ssosik/phantom-48v-injector-hat/PLAN.md

# Design log / PLAN

Numbered review items, in roughly chronological order. ✅ = closed. Coordinates quoted in
older items predate later component moves; trust the PCB, not the numbers here.

#1 - ✅ HAT stack confirmed: Pi → Phantom Injector HAT → HiFiBerry ADC.
   J1 (B.Cu socket) connects to Pi GPIO. J2 (F.Cu 2×3) connects to HiFiBerry J4.
   HiFiBerry header offset is handled by J2 position on this board. 2-hole mounting
   (MH1/MH2 at top edge) resolves height constraint from HiFiBerry's tall south-edge components.

#2 - ✅ Get proper placement of J2

#3 - ✅ Should there be separate GND planes? Or other separation of components?

#4 - ✅ HiFiBerry and Pi safety verified by simulation.
   Pi rail: π-filter (C1→L2→C6‖C8) gives −51.6 dB attenuation at 404 kHz switching frequency
   — 11.6 dB margin over −40 dB target (PLAN #32). Noise at Pi rail: 0.107 mV/A switching current.
   +48V is galvanically isolated from the Pi 5V rail except through L2/C6/C8 filter.
   DC-block caps (C13–C16, 2.2µF/100V X7R) prevent phantom DC from reaching HiFiBerry inputs.
   Audio path corner: 15 Hz derated (PLAN #33) — well below 20 Hz audio band.

#5 - ✅ what width traces should be used?

#6 - ✅ Are two switches really necessary, or would one suffice? → Decision: one switch (SW1) controls both channels simultaneously. Phantom power is a board-level enable/disable. The EM272 capsules used here all require phantom, so per-channel independent switching adds no value. SW2 removed from design.

#7 - ✅ Locate our J2 connector on the bottom side of the board to match up with J2 of the HiFiBerry

#8 - ✅ GND vias placed. As built (2026-10-29): 52 total — 3×3 grid (0.6/0.3mm) under U1 EP
   + 39 stitching vias (0.8/0.4mm), all GND net.
   Passes thermal_via DRC rule (min 0.6mm). No signal vias needed (single-layer routing).

#9 - ✅ Component separation reviewed and accepted.
   Boost section (U1, L1, L2, D1, Cx) is isolated from phantom injection area by SW1/C3 column.
   XLR connectors (J3/J4) and injection resistors (R6–R9) are in the southern zone x=100–135.
   GND pour provides isolation between zones. No additional separation required.

#10 - ✅ should the LED be on all the time, or only when the 48v switch is set?
   → Only when switched: R10 moved from +48V to +48V_SW so D2 means "phantom applied" (commit 7cfcf93).

## PCB layout optimizations (from placement review)

#11 - ✅ Move C1 (VIN bypass 10µF) and C18 (BIAS bypass 100nF) closer to U1.
   Resolved: C1 and C18 moved to y=65.48, now 5.1–5.3mm from U1. Acceptable.

#12 - ✅ D1→FB1 resolved. FB1 is now at (154.41, 80.22), 6.90mm from D1. ✓
   FB1 moved from x=128 to x=154, now sitting just left of D1/C9 column. Output side:
   FB1→C11 edge-to-edge = 0.82mm. Output cap row (C3–C11) now at y≈81 to the left of FB1.
   +48V_RAW runs D1 → FB1 (6.9mm) → filtered +48V left to cap row → injection resistors.

#13 - ✅ D1→C9 resolved. Pad-to-pad on +48V_RAW = 2.68mm. ✓
   D1 cathode pad at (156.693, 73.076), C9 +48V_RAW pad at (156.693, 75.761) — same x,
   2.68mm apart. Prior 6.25mm figure was center-to-center; pad-to-pad is the correct
   metric. 2.68mm ≈ 2.7nH additional inductance — negligible at switching frequencies.

#14 - ✅ FBX network resolved. R2→U1 = 3.71mm. ✓
   R2=(150.34, 68.07), U1=(153.87, 66.95) — 3.71mm separation. Excellent.
   R1→D1 = 12.64mm; accepted as non-critical (R1 is 1MΩ; noise into FBX attenuated
   ≈97% by divider ratio; +48V_RAW after C9 is filtered DC).

#16 - ✅ L1/D1 x-offset resolved. Δx=1.27mm, SW_NODE pad-to-pad=3.43mm. ✓
   L1 SW_NODE pad at (157.963, 65.892), D1 SW_NODE pad at (156.693, 69.076).
   3.43mm on the hottest trace — excellent. 1.27mm lateral offset is negligible.

#15 - ✅ J4 vs J3 inconsistency: incorrect, close this item.
   J4 is 2.54mm above R8, J3 is 2.54mm below R6 — both are exactly one pin pitch from their
   bias resistors, symmetric by design. No issue.

## Pre-routing checklist (from assembly/edge audit)

#17 - ✅ SW1 pads are within board. Body overhang is by design.
   All SW1 pads at y=81.97mm (7mm inside board). Bbox extends to y=90.51mm because the
   switch housing/actuator extends 8.5mm below the pad row — panel-mount style. Copper OK.

#18 - ✅ J9 not required. Board connects directly J1↔HiFiBerry; no Pi GPIO pass-through needed.

#19 - ✅ C6/C8 pad gap confirmed safe. Actual pad width=1.175mm (not 2.8mm as assumed).
   Pad-to-pad gap = 2.89 − 2×0.725 = 1.44mm. Passes 0.18mm DRC rule by wide margin.

#20 - ✅ C13/C14 and C15/C16 pad gap confirmed safe.
   Pad height (y-dimension) = 1.450mm → ±0.725mm. Gap = 2.54 − 2×0.725 = 1.09mm. Fine.

#21 - ✅ 2×3 thermal via grid placed under U1 EP. ✓
   6 vias in 2 columns × 3 rows at 1.22mm pitch, centered at (146.89, 67.34) within 0.003mm.
   All /GND net, 0.8mm dia / 0.4mm drill — passes thermal_via DRC rule (min 0.6mm).
   3 additional GND stitching vias placed near boost section: (143.69, 65.30), (143.79, 70.89),
   (149.99, 69.88) — all GND net, same spec. Confirm these are intentional before pour.

#22 - ✅ SW1 moved to x=154.6, directly below C3. +48V input is now a 5.08mm
   vertical trace (C3 pad at x=156.60 → SW1 pad2 at x=156.61). LED (D2/R10) moved
   to x≈138.6, forming a vertical column above the injection row.
   Routing plan (route before GND pour):
     • C3 → SW1 pad2: 5mm vertical at x≈156.6 (trivial)
     • SW1 pad1 (+48V_SW) west along y≈82 → R7 (x=132.5) → R8 (x=102.2)
     • Short stub from main bus → R10 pad1 at (138.56, 79.31): 2.7mm north of y=82
     • R6 and R9 are on y=84.66 — branch south from main bus
   D2 pad2 (GND) at y=87.233 — margin 1.61mm to board edge; same as J3, acceptable.

#23 - ✅ R5 moved. Now at (143.51, 57.16), bbox right=147.85mm. Well clear of board edge.

## Fresh-eyes routing pre-flight (2026-06-03)

#34 - ✅ 2-hole mounting configuration accepted (MH1 at 103.5,47.5 and MH2 at 161.5,47.5,
   both top edge). Board cannot extend south to Pi HAT standard 4-hole positions because the
   HiFiBerry board has tall components on its south edge that constrain the stack height.
   2-point mounting via top standoffs is the correct solution for this stack.

#24 - ✅ SUPERSEDED (2026-06-15). SW1 pad 3 is no longer a no-connect.
   Switch was upgraded SPST → SPDT in the schematic; pad 3 is now wired to GND
   so flipping SW1 off actively drains the phantom rail (+48V_SW → GND through
   R6-R9) instead of letting it decay across the DC-block caps. Gives a cleaner
   audible mute. wire_schematic.py NETLIST line for SW1 now has all three pins
   bound: pin 1 = +48V, pin 2 = +48V_SW (common output to R6-R9), pin 3 = GND.
   See commit 7cfcf93.

#25 - J3 GND pin (pad1) is at y=87.198mm; board bottom edge at y=88.839mm → 1.641mm margin.
   Pad edge to board edge ≈ 0.84mm (1.6mm THT pad). Passes standard fab rules (JLCPCB 0.3mm,
   PCBWay 0.5mm). Flag if fab changes — this is the tightest pad on the board.

#26 - ✅ +5V_PI fully routed — no vias needed. J1 is THT (PAD_ATTRIB_PTH); pads 2 and 4
   are directly accessible from F.Cu. Six 1.0mm-wide F.Cu tracks connect:
   J1:4 ↔ J1:2 (2.54mm) → diagonal/vertical → C6 → C8 → L2 (bus at y=59.716).
   Dangling track resolved — it is the track ending at J1 pad4.

#27 - ✅ (superseded) +5V_FILT is also routed: 23mm bus from L2:2 at (117.55,59.72)
   east to junction at x≈142.5, branching north to R5 and south to C1 → U1 VIN.
   ⚠ ISSUE: Short stubs into U1 VIN pins (pad3, pad7) are 0.25mm wide — violates the
   `power` DRC rule (min 0.5mm). Redraw those stubs at ≥0.5mm before running DRC.
   Affected tracks: near (145.0,66.6), (145.5,67-68), (145.3,68.6).

#28 - assess the layout for hand-placed hot plate soldering. Are these components too close?

## Simulation findings (2026-06-03)

#29 - ✅ SYNC_MODE wiring confirmed correct.
   U1 pin 12 routes through R11 (100kΩ) to GND → Burst + SSFM mode enabled.
   SSFM spreads the 404 kHz tone across ±20%, replacing a discrete EMI tone with
   low-level broadband noise. Correct for audio applications. ✓

#30 - ✅ V_FBX confirmed 1.600V (typ). DESIGN_DOC open item 2 closed.
   R1=1MΩ, R2=34.8kΩ → Vout = 1.60 × (1000/34.8 + 1) = 47.6V.
   Within IEC 61938 phantom power spec 48V ±4V (44–52V). ✓

#31 - ✅ Boost converter checks passed (ngspice simulation).
   IL_peak = 0.390A  (limit: 1.4A Isat, XAL5050-223MEC)  — 3.6× margin ✓
   Output ripple = 33.7mV peak-peak  (limit: 100mV) ✓
   DCM confirmed at 16mA full load ✓
   Open-loop Vout = 46.1V at D=69.2%; closed-loop FB regulates to 47.6V ✓

#32 - ✅ Pi 5V rail filter passes at 404 kHz (analytical simulation).
   Attenuation = −51.6 dB  (target: < −40 dB) — 11.6 dB margin ✓
   π-filter topology (C1 → L2 → C6║C8) gives 12 dB extra vs a simple LC.
   Noise at Pi rail: 0.107 mV per amp of switching current.

#33 - ✅ Audio path −3dB corner confirmed (analytical simulation).
   Nominal (2.2µF, no bias derating): 8.8 Hz
   Derated  (1.3µF effective at 48V): 15.0 Hz  ← design operating point
   Both below 20 Hz audio band; BirdNET bandwidth (0.05–12 kHz) is flat. ✓
   Note: TESTS.md listed 10.6 Hz (used R_inj=6.81kΩ as reference impedance — wrong).
   Correct formula uses R_HFB=8kΩ (HiFiBerry PCM1863 input Z). Simulation confirms 15 Hz.

#35 - ✅ SW1 OFF position shorted +48V to GND (fixed 2026-10-29).
   The schematic had drifted from wire_schematic.py: SW1 pin 2 (common, middle pad) was on +48V
   and pin 3 on GND, so the OFF throw shorted the boost output. The golden had been re-baselined
   with the error. Fix: re-ran wire_schematic.py (only SW1 changed in the netlist), swapped SW1
   pad 1/2 nets on the PCB, rerouted +48V from C3 through a via and a short B.Cu link to pad 1,
   and brought +48V_SW over pad 1 into pad 2 on F.Cu. DRC unchanged (1 accepted exception,
   0 unconnected); schematic parity clean. Golden re-saved. C9 value synced to 100V at the same time.

## Deferred design questions (2026-10-29)

#36 - Phantom switching transients into the HiFiBerry inputs. On SW1 ON, C13–C16 are uncharged,
   so the ADC side of each DC-block cap follows the line side. Estimated ≈ +26 V common-mode at the
   PCM1863 inputs (48 V × 8k / (6.81k + 8k)), decaying with τ ≈ 2.2 µF × 14.8 kΩ ≈ 33 ms; SW1 OFF
   gives ≈ −26 V. Rough first-order estimate; ignores cable/mic capacitance and any HiFiBerry-side
   input network. To do: check the HiFiBerry DAC2 ADC Pro input circuit; if unprotected, add a
   per-leg clamp after the DC-block cap (series R + BAV99 to rails, or low-C TVS) and re-run sim4
   for in-band loss.

#37 - Stack order. DESIGN_DOC §1 says Pi → HiFiBerry → HAT; #1 above says Pi → HAT → HiFiBerry.
   J1 is a bottom-side socket with no pass-through, so Pi → HAT → HiFiBerry leaves the HiFiBerry
   without GPIO (I²S/I²C). To do: test-fit on 11 mm standoffs; check J1 pin length and L1's 5.1 mm
   height against the board above.

#38 - J2 ↔ HiFiBerry J4 wiring. J2 is a top-side vertical header (#7 originally asked for bottom
   side). A 2×3 IDC ribbon swaps the odd and even rows. To do: decide the cable, then trace pin 1
   end to end (J2 pin 1 = R−, per DESIGN_DOC §3.4).

## v2 (2026-10-29)

#39 - ✅ v2 silkscreen. Added Logo_Sosik (project lib phantom-injector-hat.pretty, board-only
   footprint G1) and a title block on F.Silk: name, "v2 2026-10", XLR pin legend
   (1 GND / 2 HOT / 3 COLD), licence. Labels: J4 "R", J3 "L", J2 "TO HIFIBERRY J4", SW1 "P48",
   D2 "ON", U1 pin-1 dot. B.Silk: name + v2 + repo URL. PCB and schematic title blocks set
   to rev v2. One GND stitching via moved (114.78→113.6, 74.9) to clear the text. DRC: silk
   checks clean; only the documented +5V_FILT track_width exception remains.
   SW1 deliberately has no ON/OFF end marks: slide direction vs. pin 1 not yet verified.

## Housekeeping (2026-10-30)

#40 - ✅ Repo is self-contained and fab-ready.
   - LT8362 footprint MSE_16A_ADI copied from the Ultra Librarian download into
     phantom-injector-hat.pretty; U1 retargeted (schematic + PCB); fp-lib-table no longer
     references ../ul_LT8362EMSE-PBF. DRC schematic parity clean, check_netlist OK.
   - The +5V_FILT track_width exception is now a DRC exclusion in .kicad_pro (with its reason),
     so DRC reports 0 violations.
   - make_fab.sh: DRC gate, then Gerbers (9 layers), Excellon PTH/NPTH + maps, pick-and-place
     CSV and BOM into fab/ (gitignored), zipped as phantom-injector-hat-<rev>-gerbers.zip.
   - Open pre-fab items (#36–#38, SW1 direction, LTspice transient) collected in TODO.md.
