ssosik/phantom-48v-injector-hat/BOM.csv

Ref(s) | Qty | Value | Description | KiCad Footprint | Manufacturer | Mfr Part Number | DigiKey PN | DigiKey URL | Unit Price (USD) | Ext Price (USD) | Notes
U1 | 1 | LT8362EMSE-PBF | Boost/SEPIC converter IC MSOP-16-EP | ul_LT8362EMSE-PBF:MSE_16A_ADI | Analog Devices | LT8362EMSE#PBF | 505-LT8362EMSE#PBF-ND | https://www.digikey.com/en/products/detail/analog-devices-inc/LT8362EMSE%23PBF/7599731 | 6.36 | 6.36 | E-grade -40°C to 125°C
L1 | 1 | 22 µH | Shielded power inductor ≥1.4A Isat | Inductor_SMD:L_Coilcraft_XAL5030-XXX | Coilcraft | XAL5050-223MEC | N/A — order direct | https://www.coilcraft.com/en-us/products/power/shielded-inductors/xal/xal5050/ | ~3.00 | 3.00 | ⚠ Not stocked on DigiKey. Order from Coilcraft.com. XAL5030-223MEC does not exist (XAL5030 tops out ~15µH); XAL5050-223MEC is correct. Same 5×5mm pad footprint; body height 5.1mm vs 3.1mm — verify clearance above L1 in Pi/HAT/HiFiBerry stack. Isat~2.55A; 3.6× margin over 0.390A peak (PLAN #31).
L2 | 1 | 2.2 µH | Input EMI filter inductor | Inductor_SMD:L_Wuerth_HCI-7040 | Würth Elektronik | 74437324022 | 732-3331-2-ND | https://www.digikey.com/en/products/detail/wurth-electronics-inc/74437324022/2791071 | 2.35 | 2.35 | Isat=8.4A; DCR=61mΩ; HCI-7040 shielded power inductor
D1 | 1 | SS26S | 60V 2A Schottky rectifier SMA | Diode_SMD:D_SMA | Vishay | SS26S-E3/61T | SS26S-E3/61T | https://www.digikey.com/en/products/search?keywords=SS26S-E3/61T | 0.50 | 0.50 | DO-214AC (SMA) — drop-in package match for B260A. Switched from Diodes Inc. B260A-13-F due to stock-out until Oct 2026.
D2 | 1 | Green LED 3mm | Power indicator LED | LED_THT:LED_D3.0mm | (Generic) | (Generic green LED 3mm) | (any) | https://www.digikey.com/en/products/filter/leds-through-hole/105 | 0.10 | 0.10 | Any standard 3mm green LED; Vf≈2.0V; limited to ~3mA by R10
FB1 | 1 | 600Ω@100MHz 1A | EMI filter ferrite bead 0805 | Inductor_SMD:L_0805_2012Metric_Pad1.05x1.20mm_HandSolder | Murata | BLM21SP601SH1D | BLM21SP601SH1D | https://www.digikey.com/en/products/search?keywords=BLM21SP601SH1D | 0.34 | 0.34 | Power-line type ferrite bead; 2.3A rated; 0805 footprint. Order via Mfr PN — legacy 490-18588-1-ND mis-resolves (2026-06-12).
SW1 | 1 | SW_SPDT | SPDT slide switch P48 enable | Button_Switch_THT:SW_Slide_SPDT_Angled_CK_OS102011MA1Q | C&K | OS102011MA1QN1 | CKN9559-ND | https://www.digikey.com/en/products/detail/c-k/OS102011MA1QN1/1981430 | 0.71 | 0.71 | Right-angle THT; body overhangs board edge by design (PLAN #17)
J1 | 1 | 2×20 GPIO socket | 40-pin Raspberry Pi GPIO female header | Connector_PinSocket_2.54mm:PinSocket_2x20_P2.54mm_Vertical | Sullins | PPPC202LFBN-RC | S7123-ND | https://www.digikey.com/en/products/detail/sullins-connector-solutions/PPPC202LFBN-RC/810259 | 2.22 | 2.22 | ⚠ Verify pin length — needs sufficient projection to mate with Pi GPIO when HiFiBerry is sandwiched below. Consider SparkFun PRT-14017 tall stacking header ($3.50) if clearance is tight.
J2 | 1 | 2×3 pin header | HiFiBerry J4 interface connector | Connector_PinHeader_2.54mm:PinHeader_2x03_P2.54mm_Vertical | (Generic) | (Generic 2×3 2.54mm pin header) | (any) | https://www.digikey.com/en/products/filter/rectangular-connectors-headers-male-pins/314 | 0.30 | 0.30 | Pads 3/4 = GND; pinout verified against HiFiBerry datasheet (DESIGN_DOC §6 item 5)
J3 | 1 | 1×3 pin header | XLR pigtail left channel | Connector_PinHeader_2.54mm:PinHeader_1x03_P2.54mm_Vertical | (Generic) | (Generic 1×3 2.54mm pin header) | (any) | https://www.digikey.com/en/products/filter/rectangular-connectors-headers-male-pins/314 | 0.15 | 0.15 | Pin 1=GND via GND pour (DRC: 0 unconnected)
J4 | 1 | 1×3 pin header | XLR pigtail right channel | Connector_PinHeader_2.54mm:PinHeader_1x03_P2.54mm_Vertical | (Generic) | (Generic 1×3 2.54mm pin header) | (any) | https://www.digikey.com/en/products/filter/rectangular-connectors-headers-male-pins/314 | 0.15 | 0.30 | Pin 1=GND; same note as J3
MH1 MH2 | 2 | M2.5 standoff | M2.5 mounting hardware | MountingHole:MountingHole_2.7mm_M2.5 | (Hardware) | (M2.5×11mm brass standoff + screw) | (hardware) | https://www.digikey.com/en/products/filter/standoffs-spacers/582 | 0.25 | 0.50 | Board uses 2-hole mounting only (top edge); 11mm standoff height to clear GPIO connector
C1 | 1 | 10 µF / 16V X7R | VIN bypass capacitor | Capacitor_SMD:C_0805_2012Metric_Pad1.18x1.45mm_HandSolder | Samsung | CL21B106KOQNNNE | CL21B106KOQNNNE | https://www.digikey.com/en/products/search?keywords=CL21B106KOQNNNE | 0.20 | 0.20 | ⚠ Schematic shows 50V rating but C1 is on the 5V VIN rail — 16V is correct. Samsung CL21B replaces former Murata GRM21BR71C106KE51L (legacy 490- SKU mis-resolved 2026-06-12).
C2 | 1 | 1 µF / 25V X7R | VC compensation cap | Capacitor_SMD:C_0805_2012Metric_Pad1.18x1.45mm_HandSolder | Samsung | CL21B105KAFNNNE | CL21B105KAFNNNE | https://www.digikey.com/en/products/search?keywords=CL21B105KAFNNNE | 0.15 | 0.15 | Samsung CL21B; shares Mfr PN with C17 (consolidate when ordering). Replaces former Murata GRM21BR71E105KA99L (legacy 490- SKU mis-resolved → 0603 X5R 2026-06-12).
C3 | 1 | 1 µF / 100V X7R | Output filter cap (bottom of cap column) | Capacitor_SMD:C_0805_2012Metric_Pad1.18x1.45mm_HandSolder | Kyocera AVX | 08051C105KAT2A | 08051C105KAT2A | https://www.digikey.com/en/products/search?keywords=08051C105KAT2A | 0.55 | 0.55 | 1µF/100V X7R 0805. Kyocera AVX — narrow spec; most mfrs skip 1µF in 0805/100V. Replaces former Murata GRM21BC72A105KA12L (Mfr PN rejected in DigiKey order pad 2026-06-12).
C7 C10 C11 | 3 | 0.1 µF / 100V X7R | Output bypass caps | Capacitor_SMD:C_0805_2012Metric_Pad1.18x1.45mm_HandSolder | Yageo | CS0805KKX7R0BB104 | 311-3556-2-ND | https://www.digikey.com/en/products/detail/yageo/CS0805KKX7R0BB104/6097980 | 0.21 | 0.63
C4 | 1 | 1 nF X7R | FBX compensation high-freq | Capacitor_SMD:C_0805_2012Metric_Pad1.18x1.45mm_HandSolder | Yageo | CC0805KRX7R9BB102 | 311-1165-2-ND | https://www.digikey.com/en/products/detail/yageo/CC0805KRX7R9BB102/2103120 | 0.10 | 0.10
C5 | 1 | 22 nF X7R | Soft-start capacitor | Capacitor_SMD:C_0805_2012Metric_Pad1.18x1.45mm_HandSolder | Kemet | (see DigiKey 399-17886-1-ND for current Mfr PN) | 399-17886-1-ND | https://www.digikey.com/en/products/result?s=399-17886-1-ND | 0.10 | 0.10 | Updated 10nF→22nF (2026-06-12) to lengthen soft-start ~8ms→~17.6ms; cuts Pi 5V inrush ~750mA→~340mA. See DESIGN_DOC §6 item 7. Sourced as Kemet 399-17886-1-ND after Yageo CC0805KRX7R9BB223 Mfr PN mis-resolved on DigiKey order pad to 470pF/1206 part.
C6 | 1 | 22 µF / 16V X7R | Bulk input cap Pi-side | Capacitor_SMD:C_1210_3225Metric_Pad1.33x2.70mm_HandSolder | Yageo | CC1210KKX7R7BB226 | 311-2028-2-ND | https://www.digikey.com/en/products/detail/yageo/CC1210KKX7R7BB226/5195434 | 0.68 | 0.68 | Footprint updated to 1210 in schematic and PCB. ✓
C8 | 1 | 4.7 µF / 50V X7R | Input EMI filter cap | Capacitor_SMD:C_0805_2012Metric_Pad1.18x1.45mm_HandSolder | TDK | CGA4J1X7R1H475K125AC | 445-181404-1-ND | https://www.digikey.com/en/products/detail/tdk/CGA4J1X7R1H475K125AC/9742505 | 0.56 | 0.56
C9 | 1 | 10 µF / 100V X7R | Bulk output cap 48V rail | Capacitor_SMD:C_1210_3225Metric_Pad1.33x2.70mm_HandSolder | TDK | C3225X7R2A106K250AC | C3225X7R2A106K250AC | https://www.digikey.com/en/products/detail/tdk/C3225X7R2A106K250AC/15930207 | 0.80 | 0.80 | 1210 package (3225 metric). 100V rating gives ~50% derating headroom on the 48V rail. Replaces former Yageo CC1210KKX7R2BB106 (legacy 311-1577-2-ND SKU silently mis-resolved to 0201 part on order 2026-06-29).
C12 | 1 | 4.7 pF C0G | FBX feedforward cap | Capacitor_SMD:C_0805_2012Metric_Pad1.18x1.45mm_HandSolder | Yageo | CC0805CRNPO9BN4R7 | CC0805CRNPO9BN4R7 | https://www.digikey.com/en/products/search?keywords=CC0805CRNPO9BN4R7 | 0.20 | 0.20 | C0G dielectric required; stable over voltage. Replaces former Murata GRM2195C1H4R7CA01D (legacy 490- SKU mis-resolved → 1pF 0603 2026-06-12).
C13 C14 C15 C16 | 4 | 2.2 µF / 100V X7R | DC-block caps audio lines | Capacitor_SMD:C_0805_2012Metric_Pad1.18x1.45mm_HandSolder | TDK | CGA4J1X7R2A225K125AC | 445-CGA4J1X7R2A225K125ACTR-ND | https://www.digikey.com/en/products/detail/tdk-corporation/CGA4J1X7R2A225K125AC/20482636 | 0.70 | 2.80 | High-voltage DC-block for phantom power path. X7R derating at 48V → ~1.3µF effective (PLAN #33). 0805 confirmed available at 100V.
C17 | 1 | 1 µF / 10V X7R | INTVCC bypass | Capacitor_SMD:C_0805_2012Metric_Pad1.18x1.45mm_HandSolder | Samsung | CL21B105KAFNNNE | CL21B105KAFNNNE | https://www.digikey.com/en/products/search?keywords=CL21B105KAFNNNE | 0.10 | 0.10 | Low-ESR ceramic per LT8362 datasheet. Shares Samsung CL21B105KAFNNNE with C2 (25V part satisfies 10V min); consolidate when ordering. Replaces former Murata GRM21BR71A105KA01L (legacy 490- SKU not found 2026-06-12).
C18 | 1 | 100 nF / 16V X7R | BIAS pin local bypass | Capacitor_SMD:C_0805_2012Metric_Pad1.18x1.45mm_HandSolder | Samsung | CL21B104KBCNNNC | CL21B104KBCNNNC | https://www.digikey.com/en/products/search?keywords=CL21B104KBCNNNC | 0.10 | 0.10 | 100nF ceramic per LT8362 datasheet §7. Samsung CL21B 16V (10V min spec satisfied). Replaces former Murata GRM21BR71A104KA01L (legacy 490- SKU mis-resolved 2026-06-12).
R1 | 1 | 1 MΩ 1% | FBX top divider | Resistor_SMD:R_0805_2012Metric_Pad1.20x1.40mm_HandSolder | Yageo | RC0805FR-071ML | 311-1.00MFRCT-ND | https://www.digikey.com/en/products/detail/yageo/RC0805FR-071ML/730165 | 0.10 | 0.10
R2 | 1 | 34.8 kΩ 1% | FBX bottom divider (sets Vout=47.6V) | Resistor_SMD:R_0805_2012Metric_Pad1.20x1.40mm_HandSolder | Yageo | RC0805FR-0734K8L | 311-34.8KFRCT-ND | https://www.digikey.com/en/products/detail/yageo/RC0805FR-0734K8L/731148 | 0.10 | 0.10 | Sets Vout=47.6V with R1; verified by simulation (PLAN #30)
R3 | 1 | 121 kΩ 1% | R_T switching frequency | Resistor_SMD:R_0805_2012Metric_Pad1.20x1.40mm_HandSolder | Yageo | RC0805FR-07121KL | 311-121KFRCT-ND | https://www.digikey.com/en/products/detail/yageo/RC0805FR-07121KL/730895 | 0.10 | 0.10 | Sets fsw=404kHz per LT8362 datasheet formula
R4 | 1 | 22.1 kΩ 1% | VC compensation | Resistor_SMD:R_0805_2012Metric_Pad1.20x1.40mm_HandSolder | Yageo | RC0805FR-0722K1L | 311-22.1KFRCT-ND | https://www.digikey.com/en/products/detail/yageo/RC0805FR-0722K1L/730977 | 0.10 | 0.10
R5 R11 | 2 | 100 kΩ 1% | EN/UVLO pull-up + SYNC/MODE pull-down | Resistor_SMD:R_0805_2012Metric_Pad1.20x1.40mm_HandSolder | Yageo | RC0805FR-07100KL | 311-100KFRCT-ND | https://www.digikey.com/en/products/detail/yageo/RC0805FR-07100KL/730882 | 0.10 | 0.20 | R11 sets Burst+SSFM mode (PLAN #29)
R6 R7 R8 R9 | 4 | 6.81 kΩ 0.1% | Phantom power injection resistors | Resistor_SMD:R_0805_2012Metric_Pad1.20x1.40mm_HandSolder | Panasonic | ERA-6AEB6811V | P6.81KDACT-ND | https://www.digikey.com/en/products/detail/panasonic-industry/ERA-6AEB6811V/2025739 | 0.10 | 0.40 | 0.1% tolerance required for IEC 61938 balance; 6.81kΩ per IEC standard
R10 | 1 | 12 kΩ 1/4W | LED current limiter | Resistor_SMD:R_0805_2012Metric_Pad1.20x1.40mm_HandSolder | Yageo | RC0805FR-0712KL | RC0805FR-0712KL | https://www.digikey.com/en/products/search?keywords=RC0805FR-0712KL | 0.10 | 0.10 | Limits LED current to ~3mA at 48V; 1/4W rated (P=192mW). Order via Mfr PN — 311-12KFRCT-ND legacy SKU not found (2026-06-12).
 |  | TOTALS |  |  |  |  |  |  |  | 23.30 | Excludes: Coilcraft L1 (~$3 direct); M2.5 hardware; LED; generic connectors
 |  | OPEN ITEMS — resolve before ordering
 |  | 1. ✅ C9 voltage rating upgraded 50V→63V→100V (see item 11).
 |  | 2. ✅ C1 voltage rating corrected 50V→16V — schematic updated to match.
 |  | 3. ✅ C6 footprint updated to 1210 in schematic and PCB.
 |  | 4. ✅ J2 pads 3 and 4 assigned GND in wire_schematic.py NETLIST — verified in PCB.
 |  | 5. ✅ J3 pad1 and J4 pad1 assigned /GND — connected via GND pour. Verified 0 unconnected in DRC.
 |  | 6. J1 pin length — verify GPIO socket height for Pi→HAT→HiFiBerry stack clearance
 |  | 7. L1 Coilcraft XAL5050-223MEC — order direct from coilcraft.com
 |  | 8. ✅ C3 value conflict resolved — C3 is 1µF/100V (output filter); C7/C10/C11 are 0.1µF/100V bypasses. BOM split into separate rows.
 |  | 9. ✅ SKU backport (2026-06-12) — DigiKey legacy 490- (Murata) and 311-12KFRCT (Yageo) SKUs replaced with working alternatives. C1/C2/C3/C12/C17/C18 switched to Samsung CL21B / Kyocera AVX / Yageo. FB1 + R10 kept Mfr but use Mfr PN directly in order pad. See reference_digikey_ordering.md memory for full pattern.
 |  | 10. ✅ C5 soft-start cap raised 10nF → 22nF (2026-06-12) — analytical Pi 5V inrush check (DESIGN_DOC §6 item 7) found original 10 nF gives ~750 mA over 8 ms (over HAT 600 mA spec). 22 nF cuts to ~340 mA over 17.6 ms with no functional cost. Schematic/PCB/order CSV all updated.
 |  | 11. ✅ C9 mfr/voltage upgrade (2026-06-29) — Yageo 311-1577-2-ND legacy SKU silently mis-resolved to 0201 (instead of intended 1210) on DigiKey order. Switched to TDK C3225X7R2A106K250AC (10µF/100V/X7R/1210). Voltage rating bumped 63V→100V for extra derating headroom. Schematic/PCB/order CSV all updated.
