ssosik/phantom-48v-injector-hat/phantom-injector-hat-BOM.xlsx

Section | Ref | Value | Description | Package | Manufacturer | Mfr Part # | DigiKey Part # | Unit Price | Qty per Board | Qty for 5 boards | Qty for 5+10% spares | Ext. (1 unit) | Ext. (5 units)
--- Boost converter (LT8362 reference design, hand-assembly sizing) ---
Boost | U1 | LT8362HMSE#PBF | Boost converter, 60V SW, 400 kHz SSFM, H-grade (-40~125°C) | MSOP-16-EP | Analog Devices | LT8362HMSE#PBF | LT8362HMSE#PBF-ND | $6.95 | 1 | 5 | 6 | $6.95 | $41.70
Boost | L1 | 22 µH | Shielded power inductor, ≥1.4A Isat | 5.3×5.5 mm SMT | Coilcraft | XAL5030-223MEC | 1798-XAL5030-223MECCT-ND | $1.85 | 1 | 5 | 6 | $1.85 | $11.10
Boost | L2 | 2.2 µH | Input EMI filter inductor | 7.3×7.3 mm SMT | Würth | 74437324022 | 732-74437324022-ND | $1.20 | 1 | 5 | 6 | $1.20 | $7.20
Boost | D1 | B260A | 60V 2A Schottky in SMA package (easier hand assembly) | SMA / DO-214AC | Diodes Inc | B260A-13-F | B260A-FDICT-ND | $0.65 | 1 | 5 | 6 | $0.65 | $3.90
Boost | FB1 | 600Ω @ 100MHz | Output EMI filter ferrite bead, 1A | 1206 | Würth | 742792044 | 732-742792044-ND | $0.62 | 1 | 5 | 6 | $0.62 | $3.72
Boost | R1 | 1 MΩ 1% | FBX top divider | 0805 | Yageo | RC0805FR-071ML | 311-1.0MCRCT-ND | $0.10 | 1 | 5 | 6 | $0.10 | $0.60
Boost | R2 | 34.8 kΩ 1% | FBX bottom divider | 0805 | Yageo | RC0805FR-0734K8L | 311-34.8KCRCT-ND | $0.10 | 1 | 5 | 6 | $0.10 | $0.60
Boost | R3 | 121 kΩ 1% | R_T, sets 400 kHz | 0805 | Yageo | RC0805FR-07121KL | 311-121KCRCT-ND | $0.10 | 1 | 5 | 6 | $0.10 | $0.60
Boost | R4 | 22.1 kΩ 1% | V_C compensation | 0805 | Yageo | RC0805FR-0722K1L | 311-22.1KCRCT-ND | $0.10 | 1 | 5 | 6 | $0.10 | $0.60
Boost | R5 | 100 kΩ 1% | EN/UVLO pull-up | 0805 | Yageo | RC0805FR-07100KL | 311-100KCRCT-ND | $0.10 | 1 | 5 | 6 | $0.10 | $0.60
Boost | C1 | 10 µF 50V X7R | V_IN bypass to U1 | 1210 | Murata | GRM32ER71H106KA12L | 490-10758-1-ND | $0.95 | 1 | 5 | 6 | $0.95 | $5.70
Boost | C2 | 1 µF 25V X7R | V_C compensation | 0805 | Murata | GRM21BR71E105KA99L | 490-3334-1-ND | $0.18 | 1 | 5 | 6 | $0.18 | $1.08
Boost | C3 | 1 µF 100V X7R | Output filter | 1206 | Murata | GRM31CR72A105KA01L | 490-5524-1-ND | $0.65 | 1 | 5 | 6 | $0.65 | $3.90
Boost | C4 | 1 nF X7R | Compensation high-freq | 0805 | Murata | GRM21BR71H102KA01L | 490-3326-1-ND | $0.12 | 1 | 5 | 6 | $0.12 | $0.72
Boost | C5 | 10 nF X7R | Soft-start cap | 0805 | Murata | GRM21BR71H103KA01L | 490-1666-1-ND | $0.12 | 1 | 5 | 6 | $0.12 | $0.72
Boost | C6 | 22 µF 16V X7R | Bulk input | 1210 | Murata | GRM32ER71C226KE15L | 490-10745-1-ND | $0.85 | 1 | 5 | 6 | $0.85 | $5.10
Boost | C7 | 0.1 µF 100V X7R | Output bypass | 0805 | Murata | GRM21BR72A104KA01L | 490-7297-1-ND | $0.22 | 1 | 5 | 6 | $0.22 | $1.32
Boost | C8 | 4.7 µF 50V X7R | Input EMI filter cap | 1210 | Murata | GRM32ER71H475KA88L | 490-7359-1-ND | $0.75 | 1 | 5 | 6 | $0.75 | $4.50
Boost | C9 | 10 µF 50V X7R | Bulk output cap | 1210 | Murata | GRM32ER71H106KA12L | 490-10758-1-ND | $0.95 | 1 | 5 | 6 | $0.95 | $5.70
Boost | C10a | 0.1 µF 100V X7R | Output bypass | 0805 | Murata | GRM21BR72A104KA01L | 490-7297-1-ND | $0.22 | 1 | 5 | 6 | $0.22 | $1.32
Boost | C10b | 0.1 µF 100V X7R | Output bypass | 0805 | Murata | GRM21BR72A104KA01L | 490-7297-1-ND | $0.22 | 1 | 5 | 6 | $0.22 | $1.32
Boost | C11 | 4.7 pF C0G 50V | FBX feedforward (loop stability) | 0805 | Murata | GRM2165C1H4R7CA01D | 490-3303-1-ND | $0.18 | 1 | 5 | 6 | $0.18 | $1.08
--- Phantom injection network ---
Inject | R6 | 6.81 kΩ 0.1% | XLR L pin 2 bias (matched pair w/ R7) | 0805 | Susumu | RR1220P-682-D | RR12P6.81KDCT-ND | $0.45 | 1 | 5 | 6 | $0.45 | $2.70
Inject | R7 | 6.81 kΩ 0.1% | XLR L pin 3 bias (matched pair w/ R6) | 0805 | Susumu | RR1220P-682-D | RR12P6.81KDCT-ND | $0.45 | 1 | 5 | 6 | $0.45 | $2.70
Inject | R8 | 6.81 kΩ 0.1% | XLR R pin 2 bias (matched pair w/ R9) | 0805 | Susumu | RR1220P-682-D | RR12P6.81KDCT-ND | $0.45 | 1 | 5 | 6 | $0.45 | $2.70
Inject | R9 | 6.81 kΩ 0.1% | XLR R pin 3 bias (matched pair w/ R8) | 0805 | Susumu | RR1220P-682-D | RR12P6.81KDCT-ND | $0.45 | 1 | 5 | 6 | $0.45 | $2.70
Inject | SW1 | SPST slide | P48 enable, L channel, right-angle PCB-mount | C&K OS series | C&K | OS102011MA1QN1 | 401-2000-ND | $1.50 | 1 | 5 | 6 | $1.50 | $9.00
Inject | SW2 | SPST slide | P48 enable, R channel, right-angle PCB-mount | C&K OS series | C&K | OS102011MA1QN1 | 401-2000-ND | $1.50 | 1 | 5 | 6 | $1.50 | $9.00
Inject | C12 | 2.2 µF 100V X7R | DC-block L+ to HiFiBerry J4 | 1812 | Murata | GRM43ER72A225KE01L | 490-10822-1-ND | $1.85 | 1 | 5 | 6 | $1.85 | $11.10
Inject | C13 | 2.2 µF 100V X7R | DC-block L- to HiFiBerry J4 | 1812 | Murata | GRM43ER72A225KE01L | 490-10822-1-ND | $1.85 | 1 | 5 | 6 | $1.85 | $11.10
Inject | C14 | 2.2 µF 100V X7R | DC-block R+ to HiFiBerry J4 | 1812 | Murata | GRM43ER72A225KE01L | 490-10822-1-ND | $1.85 | 1 | 5 | 6 | $1.85 | $11.10
Inject | C15 | 2.2 µF 100V X7R | DC-block R- to HiFiBerry J4 | 1812 | Murata | GRM43ER72A225KE01L | 490-10822-1-ND | $1.85 | 1 | 5 | 6 | $1.85 | $11.10
--- Connectors and indicators (all through-hole) ---
Conn | J1 | 2×20 stacking header | RPi GPIO (40-pin) | THT 2.54 mm pitch | Samtec | SSQ-120-03-T-D | SAM1213-20-ND | $3.85 | 1 | 5 | 6 | $3.85 | $23.10
Conn | J2 | 2×3 box header polarized | To HiFiBerry J4 ribbon | THT 2.54 mm pitch | Würth | 61300621121 | 732-5318-ND | $0.65 | 1 | 5 | 6 | $0.65 | $3.90
Conn | J3 | 1×3 pin header | XLR pigtail, L channel | THT 2.54 mm pitch | Würth | 61300311121 | 732-5316-ND | $0.30 | 1 | 5 | 6 | $0.30 | $1.80
Conn | J4 | 1×3 pin header | XLR pigtail, R channel | THT 2.54 mm pitch | Würth | 61300311121 | 732-5316-ND | $0.30 | 1 | 5 | 6 | $0.30 | $1.80
Conn | D2 | Green LED 3 mm | +48V rail indicator | THT T-1 | Kingbright | WP710A10GD | 754-1264-ND | $0.30 | 1 | 5 | 6 | $0.30 | $1.80
Conn | R10 | 12 kΩ 1/4W | D2 LED current limit (~3.7 mA @ 48V) | 0805 | Yageo | RC0805FR-0712KL | 311-12.0KCRCT-ND | $0.10 | 1 | 5 | 6 | $0.10 | $0.60
 |  |  |  |  |  |  |  |  |  |  | TOTAL: | $34.88 | $209.28
