ssosik/phantom-48v-injector-hat/phantom-injector-hat.kicad_pcb

## KiCad design phantom-injector-hat.kicad_pcb (2026-10-30)

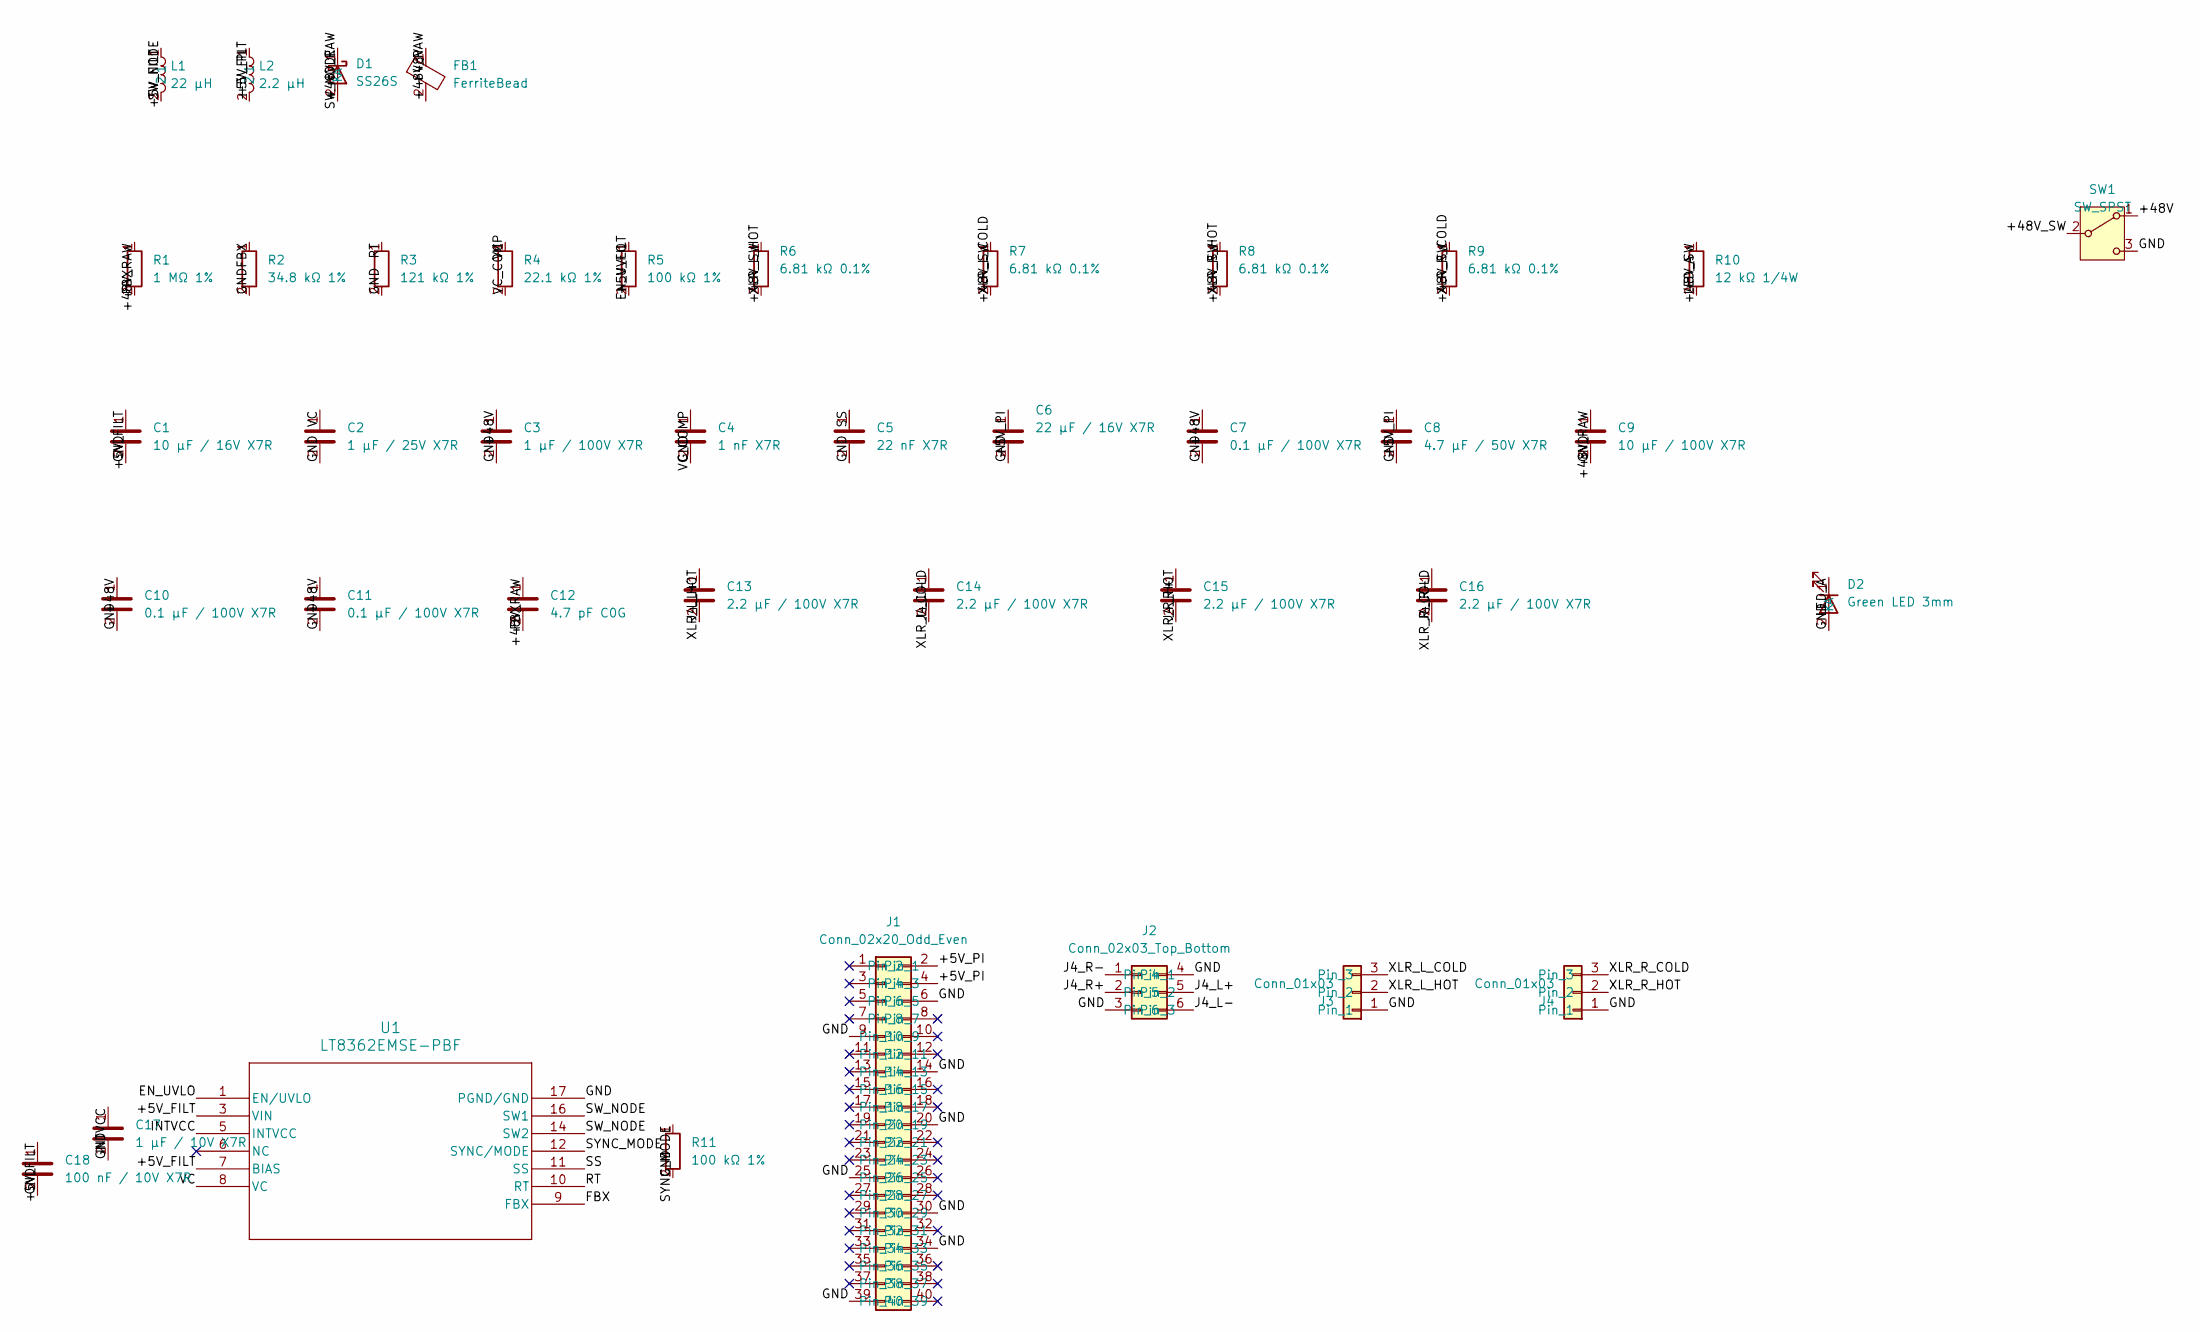
[picture p4: schematic phantom-injector-hat.kicad_sch, Phantom Power Injector HAT]

Parts:
C1: 10 µF / 16V X7R; C_0805_2012Metric_Pad1.18x1.45mm_HandSolder
C2: 1 µF / 25V X7R; C_0805_2012Metric_Pad1.18x1.45mm_HandSolder
C3: 1 µF / 100V X7R; C_0805_2012Metric_Pad1.18x1.45mm_HandSolder
C4: 1 nF X7R; C_0805_2012Metric_Pad1.18x1.45mm_HandSolder
C5: 22 nF X7R; C_0805_2012Metric_Pad1.18x1.45mm_HandSolder
C6: 22 µF / 16V X7R; C_1210_3225Metric_Pad1.33x2.70mm_HandSolder
C7, C10, C11: 0.1 µF / 100V X7R; C_0805_2012Metric_Pad1.18x1.45mm_HandSolder
C8: 4.7 µF / 50V X7R; C_0805_2012Metric_Pad1.18x1.45mm_HandSolder
C9: 10 µF / 100V X7R; C_1210_3225Metric_Pad1.33x2.70mm_HandSolder
C12: 4.7 pF C0G; C_0805_2012Metric_Pad1.18x1.45mm_HandSolder
C13, C14, C15, C16: 2.2 µF / 100V X7R; C_0805_2012Metric_Pad1.18x1.45mm_HandSolder
C17: 1 µF / 10V X7R; C_0805_2012Metric_Pad1.18x1.45mm_HandSolder
C18: 100 nF / 10V X7R; C_0805_2012Metric_Pad1.18x1.45mm_HandSolder
D1: SS26S; D_SMA
D2: Green LED 3mm; LED_D3.0mm
FB1: FerriteBead; L_0805_2012Metric_Pad1.05x1.20mm_HandSolder
J1: Conn_02x20_Odd_Even; PinSocket_2x20_P2.54mm_Vertical
J2: Conn_02x03_Top_Bottom; PinHeader_2x03_P2.54mm_Vertical
J3, J4: Conn_01x03; PinHeader_1x03_P2.54mm_Vertical
L1: 22 µH; L_Coilcraft_XAL5030-XXX
L2: 2.2 µH; L_Wuerth_HCI-7040
R1: 1 MΩ 1%; R_0805_2012Metric_Pad1.20x1.40mm_HandSolder
R2: 34.8 kΩ 1%; R_0805_2012Metric_Pad1.20x1.40mm_HandSolder
R3: 121 kΩ 1%; R_0805_2012Metric_Pad1.20x1.40mm_HandSolder
R4: 22.1 kΩ 1%; R_0805_2012Metric_Pad1.20x1.40mm_HandSolder
R5, R11: 100 kΩ 1%; R_0805_2012Metric_Pad1.20x1.40mm_HandSolder
R6, R7, R8, R9: 6.81 kΩ 0.1%; R_0805_2012Metric_Pad1.20x1.40mm_HandSolder
R10: 12 kΩ 1/4W; R_0805_2012Metric_Pad1.20x1.40mm_HandSolder
SW1: SW_SPST; SW_Slide_SPDT_Angled_CK_OS102011MA1Q
U1: LT8362EMSE-PBF; MSE_16A_ADI

Connections:
/+5V_FILT: C1.1, C18.1, L1.1, L2.2, R5.2, U1.3 (VIN), U1.7 (BIAS)
/+5V_PI: C6.1, C8.1, J1.2, J1.4, L2.1
/+48V: C3.1, C7.1, C10.1, C11.1, FB1.1, SW1.1 (A)
/+48V_RAW: C9.1, C12.1, D1.2 (A), FB1.2, R1.1
/+48V_SW: R6.1, R7.1, R8.1, R9.1, R10.1, SW1.2 (B)
/EN_UVLO: R5.1, U1.1 (EN/UVLO)
/FBX: C12.2, R1.2, R2.1, U1.9 (FBX)
/GND: C1.2, C2.2, C3.2, C4.2, C5.2, C6.2, C7.2, C8.2, C9.2, C10.2, C11.2, C17.2, C18.2, D2.2 (A), J1.6, J1.9, J1.14, J1.20, J1.25, J1.30, J1.34, J1.39, J2.3, J2.4, J3.1, J4.1, R2.2, R3.2, R11.2, SW1.3 (C), U1.17 (PGND/GND)
/INTVCC: C17.1, U1.5 (INTVCC)
/J4_L+: C13.2, J2.5
/J4_L-: C14.2, J2.6
/J4_R+: C15.2, J2.2
/J4_R-: C16.2, J2.1
/LED_A: D2.1 (K), R10.2
/RT: R3.1, U1.10 (RT)
/SS: C5.1, U1.11 (SS)
/SW_NODE: D1.1 (K), L1.2, U1.14 (SW2), U1.16 (SW1)
/SYNC_MODE: R11.1, U1.12 (SYNC/MODE)
/VC: C2.1, R4.1, U1.8 (VC)
/VC_COMP: C4.1, R4.2
/XLR_L_COLD: C14.1, J3.3, R7.2
/XLR_L_HOT: C13.1, J3.2, R6.2
/XLR_R_COLD: C16.1, J4.3, R9.2
/XLR_R_HOT: C15.1, J4.2, R8.2

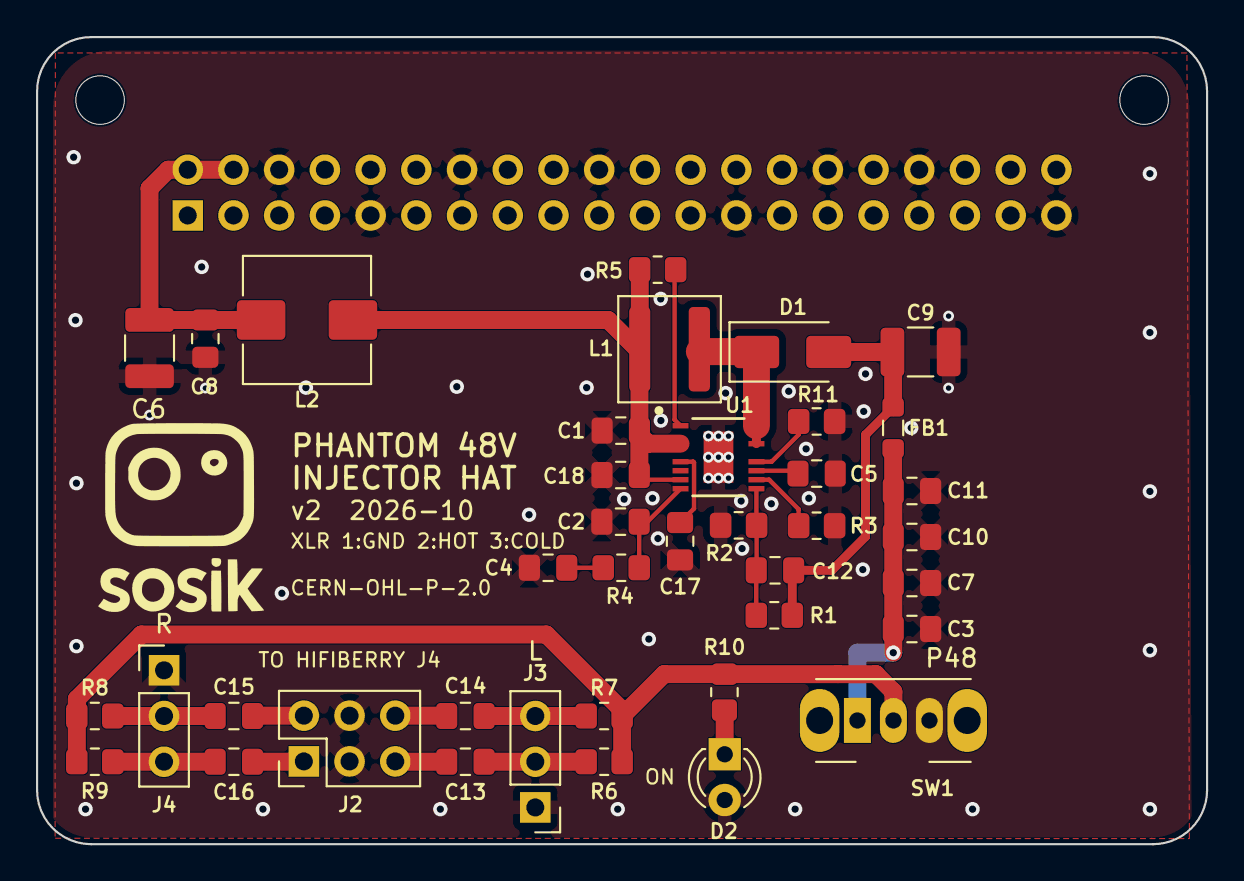
[picture p5: board phantom-injector-hat.kicad_pcb from above]

Board: 2 copper layers, 65.0 x 44.8 mm, 43 parts (1 on the bottom side), 24 nets.

Other parts of the board:
G1: Logo_Sosik
MH1, MH2: MountingHole_2.7mm_M2.5
