ssosik/phantom-48v-injector-hat/(commit log)

2026-05-13 Wiring the schematic WIP
2026-05-14 Add R11/C16, fix SYNC/MODE for Burst+SSFM, fix script idempotency
    - Add R11 (100kΩ, 0805): SYNC/MODE pull-down to GND, selects Burst+SSFM
    mode per LT8362 datasheet (low EMI at load, low quiescent when idle)
    - Add C16 (1µF/10V X7R, 0805): INTVCC bypass, required minimum per datasheet
    (INTVCC = 3.2V LDO; 1µF low ESR ceramic is mandatory, not optional)
    - Fix U1 pin 12 (SYNC/MODE) net: was incorrectly tied to GND (Burst only),
    now on SYNC_MODE net driven by R11
    - Fix wire_schematic.py block extraction: use explicit '\t' prefix instead of
    scanning back to line_start, preventing extra ')' accumulation on each run
    - Verify V_FB = 1.60V from LT8362 datasheet (closes open item)
    - ERC: 13 w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
2026-05-14 Add C17/C18, fix C10a/C10b annotation, register U1 footprint library
    - Rename C10a→C10, C10b→C11, cascade C11-C17→C12-C18 (KiCad requires
    numeric-only suffixes; C10a/C10b caused ERC annotation errors)
    - Add C18 (100nF 0805 X7R): BIAS pin local bypass per LT8362 datasheet
    - Create fp-lib-table registering ul_LT8362EMSE-PBF via ${KIPRJMOD}-relative
    path; update U1 footprint to ul_LT8362EMSE-PBF:MSE_16A_ADI
    - Add ERC.rpt (13 warnings, 0 errors — all expected pin_to_pin from
    unspecified LT8362 pin types + footprint_link_issues now resolved)
    - Add lt8362.pdf datasheet
2026-05-14 Assign correct footprints to SW1/SW2 and U1; add switch datasheet
    SW1/SW2: replace placeholder footprints with
    Button_Switch_THT:SW_Slide_SPDT_Angled_CK_OS102011MA1Q (standard KiCad
    library, no fp-lib-table entry needed). Physical pad 3 will be unconnected
    in DRC — expected, as the SPST symbol only drives pins 1 and 2.
    U1: footprint already updated in prior commit; kicad_pro touched by KiCad.
    Add Littelfuse-CK-Slide-OS-Series-Datasheet.pdf for reference.
2026-05-15 Fix all footprints; create initial PCB with board outline and DRU
    Schematic footprint fixes (9 components had wrong or empty footprints):
    - J1: empty → PinSocket_2x20_P2.54mm_Vertical (Pi GPIO stacking header)
    - J2: empty → PinHeader_2x03_P2.54mm_Vertical (HiFiBerry J4 ribbon)
    - J3/J4: SW_Slide_SPDT (wrong) → PinHeader_1x03_P2.54mm_Vertical (XLR pigtails)
    - D1: D_SMB (wrong package) → D_SMA (B260A is DO-214AC/SMA)
    - D2: empty → LED_D3.0mm (3mm through-hole LED)
    - L2: empty → L_Wuerth_HCI-7040 (closest std footprint; verify pad layout)
    - C3: SW_Slide_SPDT (wrong) → C_1206_3216Metric HandSolder
    - C12: C_0805 (wrong size) → C_1812_4532Metric HandSolder
    PCB:
    - phantom-injector-h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
2026-05-15 Set SW1 and SW2 footprint to CK OS102011MA1Q slide switch
2026-05-16 Fix C12 footprint: 4.7pF FBX feedforward cap is 0805, not 1812
2026-05-16 Initial component placement for PCB layout
    Place all 41 footprints at computed positions via place_components.py:
    boost converter stage (U1, L1, L2, D1, passives), phantom injection
    section (SW1/SW2 at right edge, R6-R9 bias, C13-C16 DC-block, J3/J4),
    LED indicator, and connectors. J2 (HiFiBerry) is a placeholder pending
    physical measurement of HiFiBerry DAC2 ADC Pro J4 position.
2026-05-16 Downsize footprints to 0805 for hot-plate reflow; fix component placement overlaps
    - C1, C3, C6, C8, C13-C16: 1210/1206/1812 → 0805 (C9 stays 1206, on 48V rail)
    - FB1: 1206 → 0805 ferrite bead
    - place_components.py: fix overlapping groups (R6-R9 spacing, C13-C16 two-column
    layout, C10/FB1 vertical clearance, R10/D2 moved below J1 courtyard, J3/J4
    repositioned away from R2)
2026-05-16 Fix DRC rule syntax errors for KiCad 10
    - Replace =~ regex with explicit net name equality checks (=~ on \+ pattern
    caused parse error in KiCad 10's expression engine)
    - Remove via_drill constraint (not valid in KiCad 10; via_diameter is sufficient)
    - Scope thermal_via rule to GND net to suppress same-condition warning
2026-05-16 Fix DRC courtyard overlaps, shorts, and U1 clearance rule
    Placement fixes:
    - C18/C2: increase column spacing to 4.5mm (was 3mm/3.5mm) to eliminate
    shorts between adjacent pads at x=127.5
    - C4: move out of passive column to (132.5, 67.5, 0) between U1 and R4
    - SW1/SW2: move up (y=75/87.5) to clear MH4 mounting hole courtyard
    - J3/J4: align to same x=126, y=82/91 to eliminate courtyard overlap
    - D2: shift left 1mm (x=161) so GND pad clears right board edge by 1.46mm
    DRC rule: add msop_clearance exception (0.15mm) for U1 intra-pad pairs —
    MSOP-16 0.5mm pitch gives 0.1956mm gap, below the 0.2mm signal rule
    Remaining manual fixes needed in KiCad PCB editor:
    - Board outline gap at bottom-lef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
2026-05-16 Tighten MSOP-16 clearance rule: use footprint lib ID, set 0.18mm
    Switched from A.Reference == 'U1' to A.Footprint == 'ul_LT8362EMSE-PBF:MSE_16A_ADI'
    for more robust matching. Set clearance to 0.18mm (actual gap is 0.1956mm —
    pad 0.3048mm tall on 0.5mm pitch). Uses footprint lib ID so it survives
    reference renumbering.
2026-05-16 Fix J1 GPIO header layer (F.Cu→B.Cu), courtyard/silk geometry; add CLAUDE.md
    - Convert J1 2x20 socket from F.Cu +90° to B.Cu -90° to match the official
    RPi HAT template (socket housing faces down toward Pi)
    - Negate pad y-coords and set rotation to 270° so PCB-world positions are
    preserved (pad 2 +5V_PI at 108.37,46.23; pad 4 at 110.91,46.23 verified)
    - Fix J1 B.CrtYd, B.SilkS, B.Fab fp_line y-coords: same y-negation bug had
    placed the courtyard on the wrong side of the connector, causing MH1 to
    appear inside J1's courtyard; negating again restores the correct extent
    matching the official template (PCB x=106.57–158.37)
    - Fix DRC rules: remove broken msop_clearance rule (A.Fo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
2026-05-21 checkpoint before final layout and wiring
2026-06-05 working on BoM
2026-06-05 Add BOM
2026-06-13 Resolve DESIGN_DOC open items #2 (V_FB) and #6 (SW1 footprint)
    - Item #2: verified LT8362 FBX regulation voltage = 1.600 V typ
    (1.568 V min / 1.636 V max) against datasheet Electrical
    Characteristics. R1=1MΩ/R2=34.8kΩ gives V_OUT = 47.58 V typ,
    worst-case ~46–49 V with ±1% resistor tol — inside IEC 61938
    (48V ± 4V) spec.
    - Item #6: verified KiCad Button_Switch_THT:SW_Slide_SPDT_Angled
    _CK_OS102011MA1Q footprint matches C&K OS-series datasheet
    page 10 across all critical dimensions (pin pitch, mounting
    hole pattern, body extents). 0.1 mm oversize on signal pin
    drill noted as standard library practice.
2026-06-13 Raise C5 soft-start cap from 10nF to 22nF; resolve item #7
    Analytical Pi 5V inrush check (DESIGN_DOC §6 item 7) found the
    original 10 nF gives a calculated ~750 mA input draw for 8 ms
    during soft-start — over the 600 mA HAT continuous spec.
    Bumping C5 to 22 nF lengthens t_ss from ~8 ms to ~17.6 ms,
    cutting peak input current to ~342 mA (comfortably under HAT
    budget). Steady-state input draw post-startup is ~34 mA at
    full phantom load. Tradeoff is a 10 ms slower startup —
    irrelevant for phantom power.
    Schematic, BOM, DigiKey order CSV, and DESIGN_DOC all updated.
    Sourced as Kemet 399-17886-1-ND after Yageo CC0805 Mfr PN
    mis-resolved on DigiKey order pad.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
2026-06-13 Fix J2 right channel R+/R- swap; resolve item #5
    Re-verified §3.4 HiFiBerry J4 pinout against the DAC2 ADC Pro
    datasheet (hifiberry.com/docs/data-sheets/datasheet-dac2-adc-pro/).
    Found a bug: §3.4 had J2 pin 1 = R+, pin 2 = R-, but the datasheet
    specifies pin 1 = in R-, pin 2 = in R+ (pin 1 = left bottom corner).
    Without the fix the right channel polarity would be inverted vs
    the left, breaking stereo imaging and partially cancelling any
    downstream mono sum.
    - wire_schematic.py NETLIST: J2 pin 1/2 net assignments swapped
    - phantom-injector-hat.kicad_sch: regenerated labels via
    wire_schematic.py (large diff is noise from fresh label UUIDs;
    functional change is only J2 pins 1 and 2)
    - D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
2026-06-16 LED follows switch; SW1 active mute via SPDT pin3→GND; FB1 footprint fix
    LED indicator (D2/R10): moved R10 pin 1 from +48V (always-on
    boost output) to +48V_SW (switched). The LED now indicates
    "phantom is enabled" rather than "boost converter is running"
    — standard pro-audio convention.
    SW1 upgraded SPST → SPDT to actively drain the phantom rail
    on mute. Pin 2 (common) = +48V_SW output to R6-R9; pin 1
    (throw A) = +48V; pin 3 (throw B) = GND. Flipping the switch
    off now actively pulls +48V_SW to GND through R6-R9, giving
    a cleaner mute than letting the rail decay across the DC-block
    caps. Schematic symbol was swapped from Switch:SW_SPST to
    Switch:SW_SPDT in eeschema; wire_schematic.py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
2026-06-16 Re-baseline netlist golden, refresh DRC/ERC reports
    netlist_golden.json captured fresh after the active-mute
    addition (SW1 pin 3 = /GND). New baseline: 24 nets,
    105 pad assignments. check_netlist.py now reports clean.
    DRC.rpt and ERC.rpt regenerated alongside — same baseline
    content as before (1 known +5V_FILT track-width violation
    documented as accepted in .kicad_dru; 13 ERC warnings from
    LT8362 symbol pin types marked Unspecified by ADI's library).
2026-06-16 Close out PLAN #24: SW1 pad 3 now wired to GND, not NC
    Item was originally "mark SW1 pad 3 no-connect in KiCad GUI",
    but the SPST → SPDT upgrade in commit 7cfcf93 superseded
    this: pad 3 is now bound to GND so flipping the switch off
    actively drains +48V_SW through R6-R9 instead of letting it
    decay across the DC-block caps.
    Marking :check: with a closeout note so the unchecked-items
    grep no longer flags it.
2026-06-29 C9: switch from Yageo 63V to TDK 100V (1210); fix package mis-order
    Original order had Yageo 311-1577-2-ND for C9, which silently
    resolved on DigiKey to a 0201 part instead of the intended 1210.
    Re-ordered as TDK C3225X7R2A106K250AC (10µF / 100V / X7R /
    1210). Bumping voltage spec 63V → 100V at the same time for
    better derating headroom on the 48V rail — the 0805 vs 1210
    package was already locked in by board geometry.
    - digikey-order-5units.csv: C9 line updated to TDK Mfr PN
    - BOM.csv: C9 row rewritten with new mfr/PN/voltage; stale
    50V→63V upgrade note replaced with the sourcing story
    - BOM.csv: OPEN ITEMS #11 added with mis-resolution closeout
    - DESIGN_DOC.md §2.1 table + ratio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
2026-10-29 Add PCB layout png
2026-10-29 Prepare repo for public release: README, LICENSE, .gitignore, doc cleanup
    - Add README (overview, specs, known issues, layout, checks, ordering, safety)
    - License under CERN-OHL-P-2.0
    - Add .gitignore; untrack .kicad_prl and generated .net
    - Remove vendor datasheet PDFs (linked from README instead)
    - Move PCB screenshot to docs/img/, add 3D renders
    - Scripts: replace hard-coded /Users paths with repo-relative paths
    - Fix stale facts across DESIGN_DOC, TESTS, ROUTING_GUIDE, PLAN, BOM,
    CLAUDE.md and .kicad_dru comments
2026-10-29 Fix SW1 OFF throw shorting +48V to GND; sync C9 value
    The schematic had drifted from wire_schematic.py: SW1's common (pin 2,
    middle pad) sat on +48V with pin 3 on GND, so switching phantom off
    shorted the boost output. Re-ran wire_schematic.py (netlist diff is SW1
    only), swapped SW1 pad 1/2 nets on the PCB, and rerouted: +48V now drops
    from C3 through a via and a short B.Cu link to pad 1; +48V_SW passes over
    pad 1 into pad 2 on F.Cu.
    Also sync the C9 footprint value to the schematic (100V), which clears
    the only schematic-parity finding. DRC unchanged (1 documented exception,
    0 unconnected), ERC 0 errors. Golden netlist re-saved; renders refreshed.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
2026-10-30 v2: logo and silkscreen labels; document deferred design questions
    Silkscreen
    - Add Logo_Sosik footprint (project lib phantom-injector-hat.pretty,
    generated from logo.kicad_sym), placed as board-only G1
    - Front title block: name, v2 2026-10, XLR pin legend, licence
    - Labels: J4 "R", J3 "L", J2 "TO HIFIBERRY J4", SW1 "P48", D2 "ON",
    U1 pin-1 dot; back: name, v2, repo URL
    - PCB and schematic title blocks set to rev v2 / 2026-10-29
    - Move one GND stitching via to clear the text; zones refilled
    - DRC: silk checks clean, only the documented +5V_FILT exception remains
    Docs and housekeeping
    - README/PLAN/DESIGN_DOC: record deferred items (phantom switching
    transients into the ADC, stack orde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
2026-10-30 Housekeeping: self-contained footprint lib, DRC exclusion, fab script, TODO
    - Copy the LT8362 MSE_16A_ADI footprint into phantom-injector-hat.pretty and
    retarget U1; fp-lib-table no longer points outside the repo.
    - Exclude the documented 0.25 mm +5V_FILT track_width exception in
    .kicad_pro; DRC now reports 0 violations, 0 unconnected.
    - Add make_fab.sh: DRC + parity gate, then Gerbers, Excellon, pick-and-place,
    BOM and a zip into fab/ (gitignored).
    - Collect the open pre-fab items (PLAN #36-#38, SW1 direction, LTspice
    load transient) in TODO.md; PLAN #40 records this pass.
